tristanlorriaux/ProjetRobot/(list of files, drawings)

Other design files:
Schéma carte général.pdsprj
