tristanlorriaux/ProjetRobot/fonction.h

/* 
 * File:   fonction.h
 * Author: maiso
 *
 * Created on 20 mai 2020, 18:16
 */

#ifndef FONCTION_H
#define	FONCTION_H
#include "init.h"

void PWM(int r_cyclique);       //Fixe le rapport cyclique du PWM à r_cyclique(%)

int detectionObjet(void);       //retourne 1 s'il y a un objet entre 40cm et 150cm

void affichageLED(struct Statut *etat); //Affiche l'état du système via le canal I2C

#endif	/* FONCTION_H */
